ckrautwald/OpenTendo/adapters/ra2/previews/adapter-3d.png

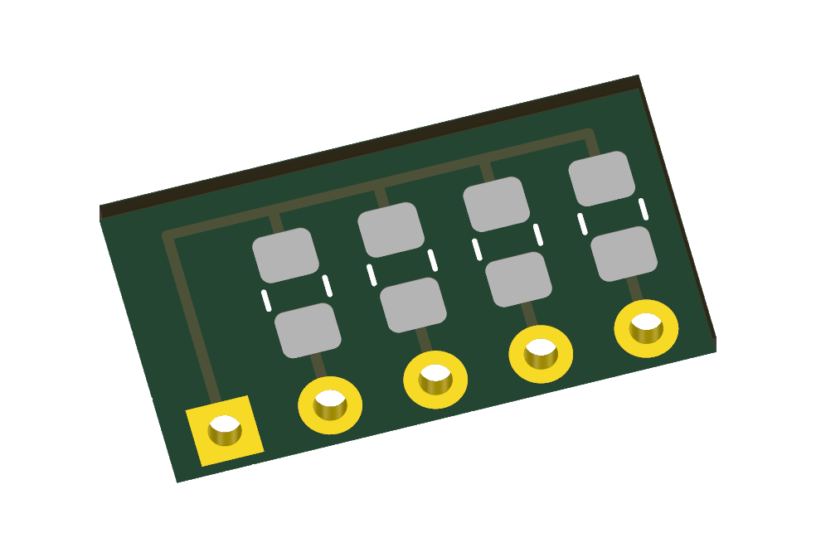
adapters/ra2/previews/adapter-3d.png
