ckrautwald/OpenTendo/BOM/BOM.csv

Query | Qty | Manufacturer | MPN | Octopart URL | Part Description | Description | Schematic Reference | Internal Part Number | Lifecycle | Lead Time | RoHS | Total Qty (@ Batch Size: 1) | SKU | SKU | SKU | SKU | SKU | Packaging | Packaging | Packaging | Packaging | Packaging | Unit Price (@ Batch Size: 1) | Unit Price (@ Batch Size: 1) | Unit Price (@ Batch Size: 1) | Unit Price (@ Batch Size: 1) | Unit Price (@ Batch Size: 1) | In Stock | In Stock | In Stock | In Stock | In Stock | MOQ | MOQ | MOQ | MOQ | MOQ | URL | URL | URL | URL | URL | Distributor [Lowest Price (Preferred Distributors)] | SKU [Lowest Price (Preferred Distributors)] | Packaging [Lowest Price (Preferred Distributors)] | Unit Price (@ Batch Size: 1) [Lowest Price (Preferred Distributors)] | Line Total [Lowest Price (Preferred Distributors)] | Batch Total [Lowest Price (Preferred Distributors)] | In Stock [Lowest Price (Preferred Distributors)] | MOQ [Lowest Price (Preferred Distributors)] | URL [Lowest Price (Preferred Distributors)] | Notes
 |  |  |  |  |  |  |  |  |  |  |  |  | Digi-Key | Mouser | Newark | Onlinecomponents.com | RS Components | Digi-Key | Mouser | Newark | Onlinecomponents.com | RS Components | Digi-Key | Mouser | Newark | Onlinecomponents.com | RS Components | Digi-Key | Mouser | Newark | Onlinecomponents.com | RS Components | Digi-Key | Mouser | Newark | Onlinecomponents.com | RS Components | Digi-Key | Mouser | Newark | Onlinecomponents.com | RS Components
CSTLS4M00G56-B0 | 1 | Murata | CSTLS4M00G56-B0 | https://octopart.com/cstls4m00g56-b0-murata-10326657 | Ceramic Resonator 4MHz ±0.5% (Tol) -0.4/0.2% (Stability) 47pF 30Ohm 3-Pin Thru-Hole Bulk |  | X2 |  | NRND (Last Updated: 2 weeks ago) | 15w | Compliant | 1 | 490-7036-ND | 81-CSTLS4M00G56-B0 | 70AC3726 |  |  | Bulk | Bulk |  |  |  | 0.21 | 0.21 | 0.209 |  |  | 4715 | 2001 | 324 |  |  | 1 | 1 | 1 |  |  | https://octopart.com/opatz8j6/a1 | https://octopart.com/opatz8j6/a1 | https://octopart.com/opatz8j6/a1 |  |  | Newark | 70AC3726 |  | 0.209 | 0.209 | 0.209 | 324 | 1 | https://octopart.com/opatz8j6/a1
ECS-214-S-4X | 1 | ECS International | ECS-214-S-4X | https://octopart.com/ecs-214-s-4x-ecs+international-88334749 |  |  | X1 |  |  |  | Compliant | 1 |  | 520-HCU2147-SX |  |  |  |  | Bulk |  |  |  |  | 0.69 |  |  |  |  | 558 |  |  |  |  | 1 |  |  |  |  | https://octopart.com/opatz8j6/a1 |  |  |  | Mouser | 520-HCU2147-SX | Bulk | 0.69 | 0.69 | 0.69 | 558 | 1 | https://octopart.com/opatz8j6/a1
SN74HCU04N | 1 | Texas Instruments | SN74HCU04N | https://octopart.com/sn74hcu04n-texas+instruments-465549 | Gate / Inverter Logic IC Leaded Process; function (IC): Hex Inverter; Base Number: 7404 |  | U9 |  | Production (Last Updated: 1 week ago) | 1w | Compliant | 1 | 296-9820-5-ND | 595-SN74HCU04N |  |  |  | Tube | Tube |  |  |  | 0.63 | 0.59 |  |  |  | 2448 | 1088 |  |  |  | 1 | 1 |  |  |  | https://octopart.com/opatz8j6/a1 | https://octopart.com/opatz8j6/a1 |  |  |  | Mouser | 595-SN74HCU04N | Tube | 0.59 | 0.59 | 0.59 | 1088 | 1 | https://octopart.com/opatz8j6/a1
SN74HC368N | 1 | Texas Instruments | SN74HC368N | https://octopart.com/sn74hc368n-texas+instruments-51845 | Buffer/Line Driver 6-CH Inverting 3-ST CMOS 16-Pin PDIP Tube |  | U8 |  | Production (Last Updated: 1 week ago) | 1w | Compliant | 1 | 296-8308-5-ND | 595-SN74HC368N |  |  |  | Tube | Tube |  |  |  | 0.65 | 0.57 |  |  |  | 4259 | 951 |  |  |  | 1 | 1 |  |  |  | https://octopart.com/opatz8j6/a1 | https://octopart.com/opatz8j6/a1 |  |  |  | Mouser | 595-SN74HC368N | Tube | 0.57 | 0.57 | 0.57 | 951 | 1 | https://octopart.com/opatz8j6/a1
SN74HC368N | 1 | Texas Instruments | SN74HC368N | https://octopart.com/sn74hc368n-texas+instruments-51845 | Buffer/Line Driver 6-CH Inverting 3-ST CMOS 16-Pin PDIP Tube |  | U7 |  | Production (Last Updated: 1 week ago) | 1w | Compliant | 1 | 296-8308-5-ND | 595-SN74HC368N |  |  |  | Tube | Tube |  |  |  | 0.65 | 0.57 |  |  |  | 4259 | 951 |  |  |  | 1 | 1 |  |  |  | https://octopart.com/opatz8j6/a1 | https://octopart.com/opatz8j6/a1 |  |  |  | Mouser | 595-SN74HC368N | Tube | 0.57 | 0.57 | 0.57 | 951 | 1 | https://octopart.com/opatz8j6/a1
ED40DT | 2 | On Shore Technology | ED40DT | https://octopart.com/ed40dt-on+shore+technology-5349672 | Conn DIP Socket SKT 40 POS Solder ST Thru-Hole |  | U5, U6 |  |  | 8w | Compliant | 2 | ED3048-5-ND |  |  |  |  | Tube |  |  |  |  | 0.59 |  |  |  |  | 1677 |  |  |  |  | 1 |  |  |  |  | https://octopart.com/opatz8j6/a1 |  |  |  |  | DigiKey | ED3048-5-ND | Tube | 0.59 | 1.18 | 1.18 | 1677 | 1 | https://octopart.com/opatz8j6/a1
SN74HC139N | 1 | Texas Instruments | SN74HC139N | https://octopart.com/sn74hc139n-texas+instruments-17212 | Decoder/Demultiplexer; Dual 2 to 4 Line Decoder-Demultiplexer; 0 to 5 V; PDIP |  | U3 |  | Production (Last Updated: 1 week ago) | 1w | Compliant | 1 | 296-8230-5-ND | 595-SN74HC139N | 33AH4851 |  |  | Tube | Tube |  |  |  | 1.31 | 1.28 | 0.147 |  |  | 102 | 1545 | 19 |  |  | 1 | 1 | 1 |  |  | https://octopart.com/opatz8j6/a1 | https://octopart.com/opatz8j6/a1 | https://octopart.com/opatz8j6/a1 |  |  | Newark | 33AH4851 |  | 0.147 | 0.147 | 0.147 | 19 | 1 | https://octopart.com/opatz8j6/a1
SN74HC373N | 1 | Texas Instruments | SN74HC373N | https://octopart.com/sn74hc373n-texas+instruments-471147 | Latch; Octal Transparent D-Type Latch; 0 to 5 V; 500 ns (Max.) @ 4.5 V; PDIP-N |  | U2 |  | Production (Last Updated: 1 week ago) | 6w | Compliant | 1 | 296-1591-5-ND | 595-SN74HC373N | 29AH1488 |  |  | Tube | Tube |  |  |  | 0.82 | 0.78 | 0.822 |  |  | 0 | 130 | 50 |  |  | 1 | 1 | 1 |  |  | https://octopart.com/opatz8j6/a1 | https://octopart.com/opatz8j6/a1 | https://octopart.com/opatz8j6/a1 |  |  | Mouser | 595-SN74HC373N | Tube | 0.78 | 0.78 | 0.78 | 130 | 1 | https://octopart.com/opatz8j6/a1
6116SA15SOG | 2 | Renesas | 6116SA15SOG | https://octopart.com/6116sa15sog-renesas-106910578 | SRAM Chip Async Single 5V 16K-Bit 2K x 8 15ns 24-Pin SOIC Tube/Tray |  | U1, U4 |  | Production (Last Updated: 1 week ago) | 1w | Compliant | 2 | 6116SA15SOG-ND | 972-6116SA15SOG |  |  |  | Tube | Tube |  |  |  | 6.44 | 6.19 |  |  |  | 282 | 202 |  |  |  | 1 | 1 |  |  |  | https://octopart.com/opatz8j6/a1 | https://octopart.com/opatz8j6/a1 |  |  |  | Mouser | 972-6116SA15SOG | Tube | 6.19 | 12.38 | 12.38 | 202 | 1 | https://octopart.com/opatz8j6/a1 | Alternate: Renesas 6116SA15TPG
PA0009 | 2 | Chip Quik | PA0009 | https://octopart.com/pa0009-chip+quik-51024752 | SOIC-24 to DIP-24 SMT Adapter |  | U1, U4 |  |  | 4w | Compliant | 2 | PA0009-ND | 910-PA0009 |  |  |  | Bulk |  |  |  |  | 5.29 | 5.29 |  |  |  | 222 | 100 |  |  |  | 1 | 1 |  |  |  | https://octopart.com/opatz8j6/a1 | https://octopart.com/opatz8j6/a1 |  |  |  | DigiKey | PA0009-ND | Bulk | 5.29 | 10.58 | 10.58 | 222 | 1 | https://octopart.com/opatz8j6/a1
4613X-101-103LF | 1 | Bourns | 4613X-101-103LF | https://octopart.com/4613x-101-103lf-bourns-1656444 | Res Thick Film NET 10K Ohm 2% 1.63W ±100ppm/°C BUS Conformal 13-Pin SIP Pin Thru-Hole Bulk |  | RA1 |  |  | 15w | Compliant | 1 | 4613X-101-103LF-ND | 652-4613X-1LF-10K | 67AC8758 | 4613X-101-103LF |  | Bulk | Bulk |  | Bulk |  | 0.75 | 0.59 | 0.643 |  |  | 887 | 704 | 541 | 0 |  | 1 | 1 | 1 | 500 |  | https://octopart.com/opatz8j6/a1 | https://octopart.com/opatz8j6/a1 | https://octopart.com/opatz8j6/a1 | https://octopart.com/opatz8j6/a1 |  | Mouser | 652-4613X-1LF-10K | Bulk | 0.59 | 0.59 | 0.59 | 704 | 1 | https://octopart.com/opatz8j6/a1
RC0805FR-076K8L | 4 | Yageo | RC0805FR-076K8L |  | 6.8 kohm 1% 0805 thick-film resistor | Four discrete pull-ups replace RA2 common-bus array | R20, R21, R22, R23 |  |  |  |  | 4
CF18JT1K00 | 2 | Stackpole Electronics | CF18JT1K00 | https://octopart.com/cf18jt1k00-stackpole+electronics-19205674 | Res Carbon Film 1K Ohm 5% 0.125W(1/8W) -400ppm/ to 0ppm/ Conformal Coated AXL T/R |  | R18, R19 |  |  | 17w | Compliant | 2 | CF18JT1K00CT-ND | 708-CF18JT1K00 |  | CF18JT1K00 |  | Cut Tape | Tape & Reel |  | Bulk |  | 0.1 | 0.1 |  |  |  | 138926 | 31947 |  | 15000 |  | 1 | 1 |  | 5000 |  | https://octopart.com/opatz8j6/a1 | https://octopart.com/opatz8j6/a1 |  | https://octopart.com/opatz8j6/a1 |  | DigiKey | CF18JT1K00CT-ND | Cut Tape | 0.1 | 0.2 | 0.2 | 138926 | 1 | https://octopart.com/opatz8j6/a1
CF14JT2K20 | 1 | Stackpole Electronics | CF14JT2K20 | https://octopart.com/cf14jt2k20-stackpole+electronics-19205454 | CF FIXED RESISTOR Axial Through Hole Resistor ±5% 0/ -400ppm/C 2.2kOhm 0.25W 1/4W |  | R17 |  |  | 17w | Compliant | 1 | CF14JT2K20CT-ND | 708-CF14JT2K20 | 31AC8468 | CF14JT2K20 |  | Cut Tape | Tape & Reel | Tape & Reel | Bulk |  | 0.1 | 0.1 |  |  |  | 157243 | 82839 | 10000 | 75000 |  | 1 | 1 | 5000 | 5000 |  | https://octopart.com/opatz8j6/a1 | https://octopart.com/opatz8j6/a1 | https://octopart.com/opatz8j6/a1 | https://octopart.com/opatz8j6/a1 |  | DigiKey | CF14JT2K20CT-ND | Cut Tape | 0.1 | 0.1 | 0.1 | 157243 | 1 | https://octopart.com/opatz8j6/a1
CFR-25JB-52-150K | 1 | Yageo | CFR-25JB-52-150K | https://octopart.com/cfr-25jb-52-150k-yageo-22569037 | General Type Carbon Film Resistor 150kOhm 1/4W 5% Axial Bulk |  | R13 |  |  | 16w | Compliant | 1 | 150KQBK-ND | 603-CFR-25JB-52-150K | 49AK4906 |  |  | Bulk | Bulk |  |  |  | 0.1 | 0.1 | 0.01 |  |  | 6389 | 1788 | 8393 |  |  | 1 | 1 | 1 |  |  | https://octopart.com/opatz8j6/a1 | https://octopart.com/opatz8j6/a1 | https://octopart.com/opatz8j6/a1 |  |  | Newark | 49AK4906 |  | 0.01 | 0.01 | 0.01 | 8393 | 1 | https://octopart.com/opatz8j6/a1
CF18JT1K20 | 1 | Stackpole Electronics | CF18JT1K20 | https://octopart.com/cf18jt1k20-stackpole+electronics-19205676 | CF FIXED RESISTOR Axial Through Hole Resistor ±5% 0/ -400ppm/C 1.2kOhm 0.125W 1/8W |  | R11 |  |  | 17w | Compliant | 1 | CF18JT1K20CT-ND | 708-CF18JT1K20 |  | CF18JT1K20 |  | Cut Tape | Tape & Reel |  | Bulk |  | 0.1 | 0.1 |  |  |  | 16462 | 9887 |  | 0 |  | 1 | 1 |  | 5000 |  | https://octopart.com/opatz8j6/a1 | https://octopart.com/opatz8j6/a1 |  | https://octopart.com/opatz8j6/a1 |  | DigiKey | CF18JT1K20CT-ND | Cut Tape | 0.1 | 0.1 | 0.1 | 16462 | 1 | https://octopart.com/opatz8j6/a1
CF18JT220K | 1 | Stackpole Electronics | CF18JT220K | https://octopart.com/cf18jt220k-stackpole+electronics-19205700 | CF FIXED RESISTOR Axial Through Hole Resistor ±5% 0/ -850ppm/C 220kOhm 0.125W 1/8W |  | R10 |  |  | 17w | Compliant | 1 | CF18JT220KCT-ND | 708-CF18JT220K |  | CF18JT220K |  | Cut Tape | Tape & Reel |  | Bulk |  | 0.1 | 0.1 |  |  |  | 30939 | 9700 |  | 0 |  | 1 | 1 |  | 5000 |  | https://octopart.com/opatz8j6/a1 | https://octopart.com/opatz8j6/a1 |  | https://octopart.com/opatz8j6/a1 |  | DigiKey | CF18JT220KCT-ND | Cut Tape | 0.1 | 0.1 | 0.1 | 30939 | 1 | https://octopart.com/opatz8j6/a1
CF18JT12K0 | 1 | Stackpole Electronics | CF18JT12K0 | https://octopart.com/cf18jt12k0-stackpole+electronics-19205652 | CF FIXED RESISTOR Axial Through Hole Resistor ±5% 0/ -500ppm/C 12kOhm 0.125W 1/8W |  | R8 |  |  | 17w | Compliant | 1 | CF18JT12K0CT-ND | 708-CF18JT12K0 |  | CF18JT12K0 |  | Cut Tape | Tape & Reel |  | Bulk |  | 0.1 | 0.1 |  |  |  | 16632 | 9736 |  | 0 |  | 1 | 1 |  | 5000 |  | https://octopart.com/opatz8j6/a1 | https://octopart.com/opatz8j6/a1 |  | https://octopart.com/opatz8j6/a1 |  | DigiKey | CF18JT12K0CT-ND | Cut Tape | 0.1 | 0.1 | 0.1 | 16632 | 1 | https://octopart.com/opatz8j6/a1
CF18JT20K0 | 2 | Stackpole Electronics | CF18JT20K0 | https://octopart.com/cf18jt20k0-stackpole+electronics-19205697 | CF FIXED RESISTOR Axial Through Hole Resistor ±5% 0/ -500ppm/C 20kOhm 0.125W 1/8W |  | R7, R9 |  |  | 17w | Compliant | 2 | CF18JT20K0CT-ND | 708-CF18JT20K0 |  | CF18JT20K0 |  | Cut Tape | Tape & Reel |  | Bulk |  | 0.1 | 0.1 |  |  |  | 66822 | 22435 |  | 0 |  | 1 | 1 |  | 5000 |  | https://octopart.com/opatz8j6/a1 | https://octopart.com/opatz8j6/a1 |  | https://octopart.com/opatz8j6/a1 |  | DigiKey | CF18JT20K0CT-ND | Cut Tape | 0.1 | 0.2 | 0.2 | 66822 | 1 | https://octopart.com/opatz8j6/a1
CF18JT47K0 | 1 | Stackpole Electronics | CF18JT47K0 | https://octopart.com/cf18jt47k0-stackpole+electronics-19205759 | Res Carbon Film 47K Ohm 5% 0.125W(1/8W) -500ppm/ to 0ppm/ Conformal Coated AXL T/R |  | R6 |  |  | 17w | Compliant | 1 | CF18JT47K0CT-ND | 708-CF18JT47K0 |  | CF18JT47K0 |  | Cut Tape | Tape & Reel |  | Bulk |  | 0.1 | 0.1 |  |  |  | 205528 | 10457 |  | 35000 |  | 1 | 1 |  | 5000 |  | https://octopart.com/opatz8j6/a1 | https://octopart.com/opatz8j6/a1 |  | https://octopart.com/opatz8j6/a1 |  | DigiKey | CF18JT47K0CT-ND | Cut Tape | 0.1 | 0.1 | 0.1 | 205528 | 1 | https://octopart.com/opatz8j6/a1
CF18JT220R | 1 | Stackpole Electronics | CF18JT220R | https://octopart.com/cf18jt220r-stackpole+electronics-19205701 | CF FIXED RESISTOR Axial Through Hole Resistor ±5% 0/ -400ppm/C 220Ohm 0.125W 1/8W |  | R5 |  |  | 17w | Compliant | 1 | CF18JT220RCT-ND | 708-CF18JT220R |  | CF18JT220R |  | Cut Tape | Tape & Reel |  | Bulk |  | 0.1 | 0.1 |  |  |  | 44352 | 7668 |  | 0 |  | 1 | 1 |  | 5000 |  | https://octopart.com/opatz8j6/a1 | https://octopart.com/opatz8j6/a1 |  | https://octopart.com/opatz8j6/a1 |  | DigiKey | CF18JT220RCT-ND | Cut Tape | 0.1 | 0.1 | 0.1 | 44352 | 1 | https://octopart.com/opatz8j6/a1
CF18JT100R | 2 | Stackpole Electronics | CF18JT100R | https://octopart.com/cf18jt100r-stackpole+electronics-19205641 | Res Carbon Film 100 Ohm 5% 0.125W(1/8W) -400ppm/ to 0ppm/ Conformal Coated AXL T/R |  | R3, R4 |  |  | 17w | Compliant | 2 | CF18JT100RCT-ND | 708-CF18JT100R |  | CF18JT100R |  | Cut Tape | Tape & Reel |  | Bulk |  | 0.1 | 0.1 |  |  |  | 80062 | 446 |  | 0 |  | 1 | 1 |  | 5000 |  | https://octopart.com/opatz8j6/a1 | https://octopart.com/opatz8j6/a1 |  | https://octopart.com/opatz8j6/a1 |  | DigiKey | CF18JT100RCT-ND | Cut Tape | 0.1 | 0.2 | 0.2 | 80062 | 1 | https://octopart.com/opatz8j6/a1
CF18JT510R | 2 | Stackpole Electronics | CF18JT510R | https://octopart.com/cf18jt510r-stackpole+electronics-19205768 | CF FIXED RESISTOR Axial Through Hole Resistor ±5% 0/ -400ppm/C 510Ohm 0.125W 1/8W |  | R2, R12 |  |  | 17w | Compliant | 2 | CF18JT510RCT-ND | 708-CF18JT510R |  | CF18JT510R |  | Cut Tape | Tape & Reel |  | Bulk |  | 0.1 | 0.1 |  |  |  | 37165 | 9636 |  | 0 |  | 1 | 1 |  | 5000 |  | https://octopart.com/opatz8j6/a1 | https://octopart.com/opatz8j6/a1 |  | https://octopart.com/opatz8j6/a1 |  | DigiKey | CF18JT510RCT-ND | Cut Tape | 0.1 | 0.2 | 0.2 | 37165 | 1 | https://octopart.com/opatz8j6/a1
RNF14FTD1M00 | 1 | Stackpole Electronics | RNF14FTD1M00 | https://octopart.com/rnf14ftd1m00-stackpole+electronics-19224733 | RNF FIXED RESISTOR Axial Through Hole Resistor ±1% ±100ppm/C 1MOhm 0.25W 1/4W |  | R1 |  |  | 17w | Compliant | 1 | RNF14FTD1M00CT-ND | 708-RNF14FTD1M00 |  | RNF14FTD1M00 |  | Cut Tape | Tape & Reel |  | Bulk |  | 0.1 | 0.1 |  |  |  | 45933 | 43168 |  | 10000 |  | 1 | 1 |  | 5000 |  | https://octopart.com/opatz8j6/a1 | https://octopart.com/opatz8j6/a1 |  | https://octopart.com/opatz8j6/a1 |  | DigiKey | RNF14FTD1M00CT-ND | Cut Tape | 0.1 | 0.1 | 0.1 | 45933 | 1 | https://octopart.com/opatz8j6/a1
2SC2021 | 2 | ROHM | 2SC2021 | https://octopart.com/2sc2021-rohm-2177186 |  |  | Q2, Q3 |  |  |  | Non-Compliant | 2
2SA937 | 1 | ROHM | 2SA937 | https://octopart.com/2sa937-rohm-2179925 |  |  | Q1 |  |  |  | Non-Compliant | 1
S7B-PH-K-S(LF)(SN) | 2 | JST | S7B-PH-K-S (LF)(SN) | https://octopart.com/s7b-ph-k-s+%28lf%29%28sn%29-jst-5373080 | Header for PCB; pitch 2.00mm; 7-contacts; THT; male; side entry; 100V/2A |  | P4, P5 |  |  |  | Compliant | 2 |  |  | 38K8083 |  |  |  |  |  |  |  |  |  |  |  |  |  |  | 78 |  |  |  |  | 10 |  |  |  |  | https://octopart.com/opatz8j6/a1 |  |  | Newark | 38K8083 |  |  |  |  | 78 | 10 | https://octopart.com/opatz8j6/a1
PPPC241LFBN-RC | 2 | Sullins | PPPC241LFBN-RC | https://octopart.com/pppc241lfbn-rc-sullins-271073 | 24 Position Header Connector 0.100 (2.54mm) Through Hole Gold |  | P2 |  |  | 11w | Compliant | 2 | S7057-ND |  |  |  |  | Tray |  |  |  |  | 1.77 |  |  |  |  | 2637 |  |  |  |  | 1 |  |  |  |  | https://octopart.com/opatz8j6/a1 |  |  |  |  | DigiKey | S7057-ND | Tray | 1.77 | 3.54 | 3.54 | 2637 | 1 | https://octopart.com/opatz8j6/a1
28L0138-10R-10 | 1 | Laird | 28L0138-10R-10 | https://octopart.com/28l0138-10r-10-laird-19252911 | Emi Ferrite Bead With Axial Wire, 5A, 75 Ohms @100MHZ, Dcr Max 0.01 Ohm |  | FC2 |  | Production (Last Updated: 3 years ago) | 14w | Compliant | 1 | 240-2438-1-ND | 875-28L0138-10R-10 | 67W0706 |  |  | Cut Tape | Tape & Reel | Cut Tape |  |  | 0.24 | 0.24 |  |  |  | 41197 | 27634 | 17994 |  |  | 1 | 1 | 10 |  |  | https://octopart.com/opatz8j6/a1 | https://octopart.com/opatz8j6/a1 | https://octopart.com/opatz8j6/a1 |  |  | DigiKey | 240-2438-1-ND | Cut Tape | 0.24 | 0.24 | 0.24 | 41197 | 1 | https://octopart.com/opatz8j6/a1
B78108S1393K | 1 | EPCOS | B78108S1393K | https://octopart.com/b78108s1393k-epcos-39569030 | Fixed Inductor RF Choke 39uH 10% Wirewound 470mA 1020 mOhm Unshielded Axial |  | FC1 |  | Production (Last Updated: 2 years ago) | 9w | Compliant | 1 | 495-5565-1-ND | 871-B78108S1393K |  |  |  | Cut Tape | Tape & Reel |  |  |  | 0.3 | 0.32 |  |  |  | 9658 | 6091 |  |  |  | 1 | 1 |  |  |  | https://octopart.com/opatz8j6/a1 | https://octopart.com/opatz8j6/a1 |  |  |  | DigiKey | 495-5565-1-ND | Cut Tape | 0.3 | 0.3 | 0.3 | 9658 | 1 | https://octopart.com/opatz8j6/a1
DAN601 | 2 | ROHM | DAN601 | https://octopart.com/dan601-rohm-14372173 |  | small signal diode array | DA1, DA3 |  |  |  | Non-Compliant | 2
1N5231BTR | 2 | onsemi | 1N5231BTR | https://octopart.com/1n5231btr-onsemi-12156453 | 1N5231 Series 500 mW 5.1 V 200 mA Through Hole Zener Diode - DO-35 |  | D1, D2 |  | Production (Last Updated: 3 years ago) | 22w | Compliant | 2 | 1N5231BFSCT-ND | 512-1N5231BTR | 05R0368 | 1N5231BTR |  | Cut Tape | Tape & Reel | Cut Tape | Bulk |  | 0.1 | 0.14 | 0.158 |  |  | 38386 | 63101 | 20617 | 120000 |  | 1 | 1 | 1 | 5000 |  | https://octopart.com/opatz8j6/a1 | https://octopart.com/opatz8j6/a1 | https://octopart.com/opatz8j6/a1 | https://octopart.com/opatz8j6/a1 |  | DigiKey | 1N5231BFSCT-ND | Cut Tape | 0.1 | 0.2 | 0.2 | 38386 | 1 | https://octopart.com/opatz8j6/a1
K560J15C0GF5TL2 | 2 | Vishay | K560J15C0GF5TL2 | https://octopart.com/k560j15c0gf5tl2-vishay-39474510 | Capacitor Ceramic 56PF 50V, C0G/NP0, 5%, |  | C43, C45 |  |  | 17w | Compliant | 2 | BC1010CT-ND | 594-K560J15C0GF5TL2 | 73AJ7908 |  |  | Cut Tape | Tape & Reel |  |  |  | 0.24 | 0.24 |  |  |  | 28892 | 14404 | 17730 |  |  | 1 | 1 | 10 |  |  | https://octopart.com/opatz8j6/a1 | https://octopart.com/opatz8j6/a1 | https://octopart.com/opatz8j6/a1 |  |  | Mouser | 594-K560J15C0GF5TL2 | Tape & Reel | 0.24 | 0.48 | 0.48 | 14404 | 1 | https://octopart.com/opatz8j6/a1
K150J15C0GF5TL2 | 1 | Vishay | K150J15C0GF5TL2 | https://octopart.com/k150j15c0gf5tl2-vishay-39474466 | K Series 15 pF 50 V ±5 % Tolerance C0G Radial Multilayer Ceramic Capacitor |  | C42 |  |  | 17w | Compliant | 1 | BC1003CT-ND | 594-K150J15C0GF5TL2 | 95C0990 |  |  | Cut Tape | Tape & Reel | Cut Tape |  |  | 0.25 | 0.25 | 0.048 |  |  | 37400 | 23292 | 5373 |  |  | 1 | 1 | 1 |  |  | https://octopart.com/opatz8j6/a1 | https://octopart.com/opatz8j6/a1 | https://octopart.com/opatz8j6/a1 |  |  | Newark | 95C0990 | Cut Tape | 0.048 | 0.048 | 0.048 | 5373 | 1 | https://octopart.com/opatz8j6/a1
C315C180J5G5TA | 1 | KEMET | C315C180J5G5TA | https://octopart.com/c315c180j5g5ta-kemet-1839992 | Cap Ceramic 18pF 50V C0G 5% Radial 2.54mm 125 C Bulk |  | C41 |  |  | 13w | Compliant | 1 | 399-C315C180J5G5TA-ND | 80-C315C180J5G5TA |  |  |  | Bulk | Bulk |  |  |  | 0.43 | 0.28 |  |  |  | 480 | 2574 |  |  |  | 1 | 1 |  |  |  | https://octopart.com/opatz8j6/a1 | https://octopart.com/opatz8j6/a1 |  |  |  | Mouser | 80-C315C180J5G5TA | Bulk | 0.28 | 0.28 | 0.28 | 2574 | 1 | https://octopart.com/opatz8j6/a1 | Alternate: TDK FG18C0G1H180JNT00
UVR2A010MDD1TD | 1 | Nichicon | UVR2A010MDD1TD | https://octopart.com/uvr2a010mdd1td-nichicon-10319218 | Radial Can ALUMINUM ELECTROLYTIC CAPACITOR UVR 100V 1muF ±20% 0.197Dia 5.00mm |  | C23 |  |  | 21w | Compliant | 1 | 493-12811-1-ND | 647-UVR2A010MDD1TD |  |  |  | Cut Tape | Ammo Pack |  |  |  | 0.27 | 0.26 |  |  |  | 2203 | 3474 |  |  |  | 1 | 1 |  |  |  | https://octopart.com/opatz8j6/a1 | https://octopart.com/opatz8j6/a1 |  |  |  | Mouser | 647-UVR2A010MDD1TD | Ammo Pack | 0.26 | 0.26 | 0.26 | 3474 | 1 | https://octopart.com/opatz8j6/a1
K221K15X7RF5TL2 | 3 | Vishay | K221K15X7RF5TL2 | https://octopart.com/k221k15x7rf5tl2-vishay-39474895 | Cap Ceramic 220pF 50V X7R 10% Radial 2.5mm 125C T/R |  | C20, C21, C44 |  |  | 17w | Compliant | 3 | BC1068CT-ND | 594-K221K15X7RF5TL2 | 57AC2378 |  |  | Cut Tape | Tape & Reel |  |  |  | 0.24 | 0.24 |  |  |  | 28648 | 29955 | 31050 |  |  | 1 | 1 | 10 |  |  | https://octopart.com/opatz8j6/a1 | https://octopart.com/opatz8j6/a1 | https://octopart.com/opatz8j6/a1 |  |  | Mouser | 594-K221K15X7RF5TL2 | Tape & Reel | 0.24 | 0.72 | 0.72 | 29955 | 1 | https://octopart.com/opatz8j6/a1
ECA-1HHG2R2I | 1 | Panasonic | ECA-1HHG2R2I | https://octopart.com/eca-1hhg2r2i-panasonic-12553061 | Cap Aluminum Lytic 2.2uF 50V 20% (5 X 11mm) Radial 2.5mm 18mA 1000h 105C Automotive Ammo |  | C9 |  | Production (Last Updated: 3 years ago) | 21w | Compliant | 1 | P19525CT-ND | 667-ECA-1HHG2R2I | 74AK7354 | ECA-1HHG2R2I |  | Cut Tape | Tape & Reel |  | Bulk |  | 0.27 | 0.26 |  |  |  | 12954 | 4884 | 5910 | 2000 |  | 1 | 1 | 5 | 2000 |  | https://octopart.com/opatz8j6/a1 | https://octopart.com/opatz8j6/a1 | https://octopart.com/opatz8j6/a1 | https://octopart.com/opatz8j6/a1 |  | Mouser | 667-ECA-1HHG2R2I | Tape & Reel | 0.26 | 0.26 | 0.26 | 4884 | 1 | https://octopart.com/opatz8j6/a1
K104K15X7RF5UH5 | 2 | Vishay | K104K15X7RF5UH5 | https://octopart.com/k104k15x7rf5uh5-vishay-40993312 | Cap Ceramic 0.1uF 50V X7R 10% Through Hole 5mm 125°C Ammo Pack |  | C8, C46 |  |  | 17w | Compliant | 2 | BC5229CT-ND | 594-K104K15X7RF5UH5 |  |  |  | Cut Tape | Ammo Pack |  |  |  | 0.26 | 0.26 |  |  |  | 35561 | 70148 |  |  |  | 1 | 1 |  |  |  | https://octopart.com/opatz8j6/a1 | https://octopart.com/opatz8j6/a1 |  |  |  | DigiKey | BC5229CT-ND | Cut Tape | 0.26 | 0.52 | 0.52 | 35561 | 1 | https://octopart.com/opatz8j6/a1
K331K15X7RF53L2 | 11 | Vishay | K331K15X7RF53L2 | https://octopart.com/k331k15x7rf53l2-vishay-42623274 | Ceramic Capacitor, Multilayer, Ceramic, 50V, 10% +Tol, 10% -Tol, X7R, 15% TC, 0.00033uF, Through Hole Mount |  | C5, C27, C28, C29, C30, C31, C33, C34, C35, C36, C37 |  |  | 17w | Compliant | 11 | BC5150-ND | 594-K331K15X7RF53L2 |  |  |  | Bulk | Bulk |  |  |  | 0.143 | 0.102 |  |  |  | 22142 | 34228 |  |  |  | 1 | 1 |  |  |  | https://octopart.com/opatz8j6/a1 | https://octopart.com/opatz8j6/a1 |  |  |  | Mouser | 594-K331K15X7RF53L2 | Bulk | 0.102 | 1.1219999999999999 | 1.1219999999999999 | 34228 | 1 | https://octopart.com/opatz8j6/a1
K103K10X7RF5UH5 | 20 | Vishay | K103K10X7RF5UH5 | https://octopart.com/k103k10x7rf5uh5-vishay-44280222 | Multilayer Ceramic Capacitor, 0.01 uF, 50 V, ï¿½ 10%, X7R, Radial Leaded |  | C2, C3, C4, C10, C11, C12, C13, C14, C15, C16, C17, C18, C19, C22, C24, C26, C32, C38, C39, C40 |  |  | 17w | Compliant | 20 | BC2662CT-ND | 594-K103K10X7RF5UH5 | 92K1095 |  |  | Cut Tape | Ammo Pack |  |  |  | 0.16 | 0.101 | 0.04 |  |  | 43219 | 32443 | 8363 |  |  | 1 | 1 | 1 |  |  | https://octopart.com/opatz8j6/a1 | https://octopart.com/opatz8j6/a1 | https://octopart.com/opatz8j6/a1 |  |  | Newark | 92K1095 |  | 0.04 | 0.8 | 0.8 | 8363 | 1 | https://octopart.com/opatz8j6/a1
ECE-A0JKA101I | 1 | Panasonic | ECE-A0JKA101I | https://octopart.com/ece-a0jka101i-panasonic-15327038 | Cap Aluminum 100uF 6.3V 20% (5 X 7mm) Radial 2.5mm 71mA 1000 hr 85°C Ammo Pack |  | C1 |  |  | 21w | Compliant | 1 | 10-ECE-A0JKA101ICT-ND | 667-ECE-A0JKA101I |  | ECE-A0JKA101I |  | Cut Tape | Tape & Reel |  | Bulk |  | 0.25 | 0.24 |  |  |  | 761 | 3609 |  | 6776 |  | 1 | 1 |  | 2000 |  | https://octopart.com/opatz8j6/a1 | https://octopart.com/opatz8j6/a1 |  | https://octopart.com/opatz8j6/a1 |  | Mouser | 667-ECE-A0JKA101I | Tape & Reel | 0.24 | 0.24 | 0.24 | 3609 | 1 | https://octopart.com/opatz8j6/a1
K153K10X7RF5UH5 | 2 | Vishay | K153K10X7RF5UH5 | https://octopart.com/k153k10x7rf5uh5-vishay-44033224 | Multilayer Ceramic Capacitors MLCC - Leaded 15000pF 50V 10% X7R 5mm LS |  | BC1, BC2 |  |  | 17w | Compliant | 2 | BC2671CT-ND | 594-K153K10X7RF5UH5 |  |  |  | Cut Tape | Ammo Pack |  |  |  | 0.24 | 0.24 |  |  |  | 18058 | 15044 |  |  |  | 1 | 1 |  |  |  | https://octopart.com/opatz8j6/a1 | https://octopart.com/opatz8j6/a1 |  |  |  | DigiKey | BC2671CT-ND | Cut Tape | 0.24 | 0.48 | 0.48 | 18058 | 1 | https://octopart.com/opatz8j6/a1
GKG30015 | 1 | Panasonic | GKG30015 | https://octopart.com/gkg30015-panasonic-120079986 | Cap Trimmer 6.5-30PF 100V Th |  | TC1 |  |  | 22w |  | 1 | 2447-GKG30015-ND |  |  |  |  | Bulk |  |  |  |  | 1.32 |  |  |  |  | 15739 |  |  |  |  | 1 |  |  |  |  | https://octopart.com/opatz8j6/a1 |  |  |  |  | DigiKey | 2447-GKG30015-ND | Bulk | 1.32 | 1.32 | 1.32 | 15739 | 1 | https://octopart.com/opatz8j6/a1
