ckrautwald/OpenTendo/adapters/ra2/BOM.csv

Reference | Quantity | Manufacturer | Part number | Description
R1 R2 R3 R4 | 4 | Yageo | RC0805FR-076K8L | 6.8 kohm 1% 0805 resistor
J1 | 5 | Unselected | Unselected | 0.5 mm diameter round tinned copper wire leads cut to length; qualify mechanically
PCB | 1 | Unselected | RA2-modern-adapter | 13 x 7 mm 2-layer 0.8 mm prototype board
