ckrautwald/OpenTendo/Board Files/Motherboard.kicad_pcb

## KiCad design Board Files/Motherboard.kicad_pcb (2026-11-01)

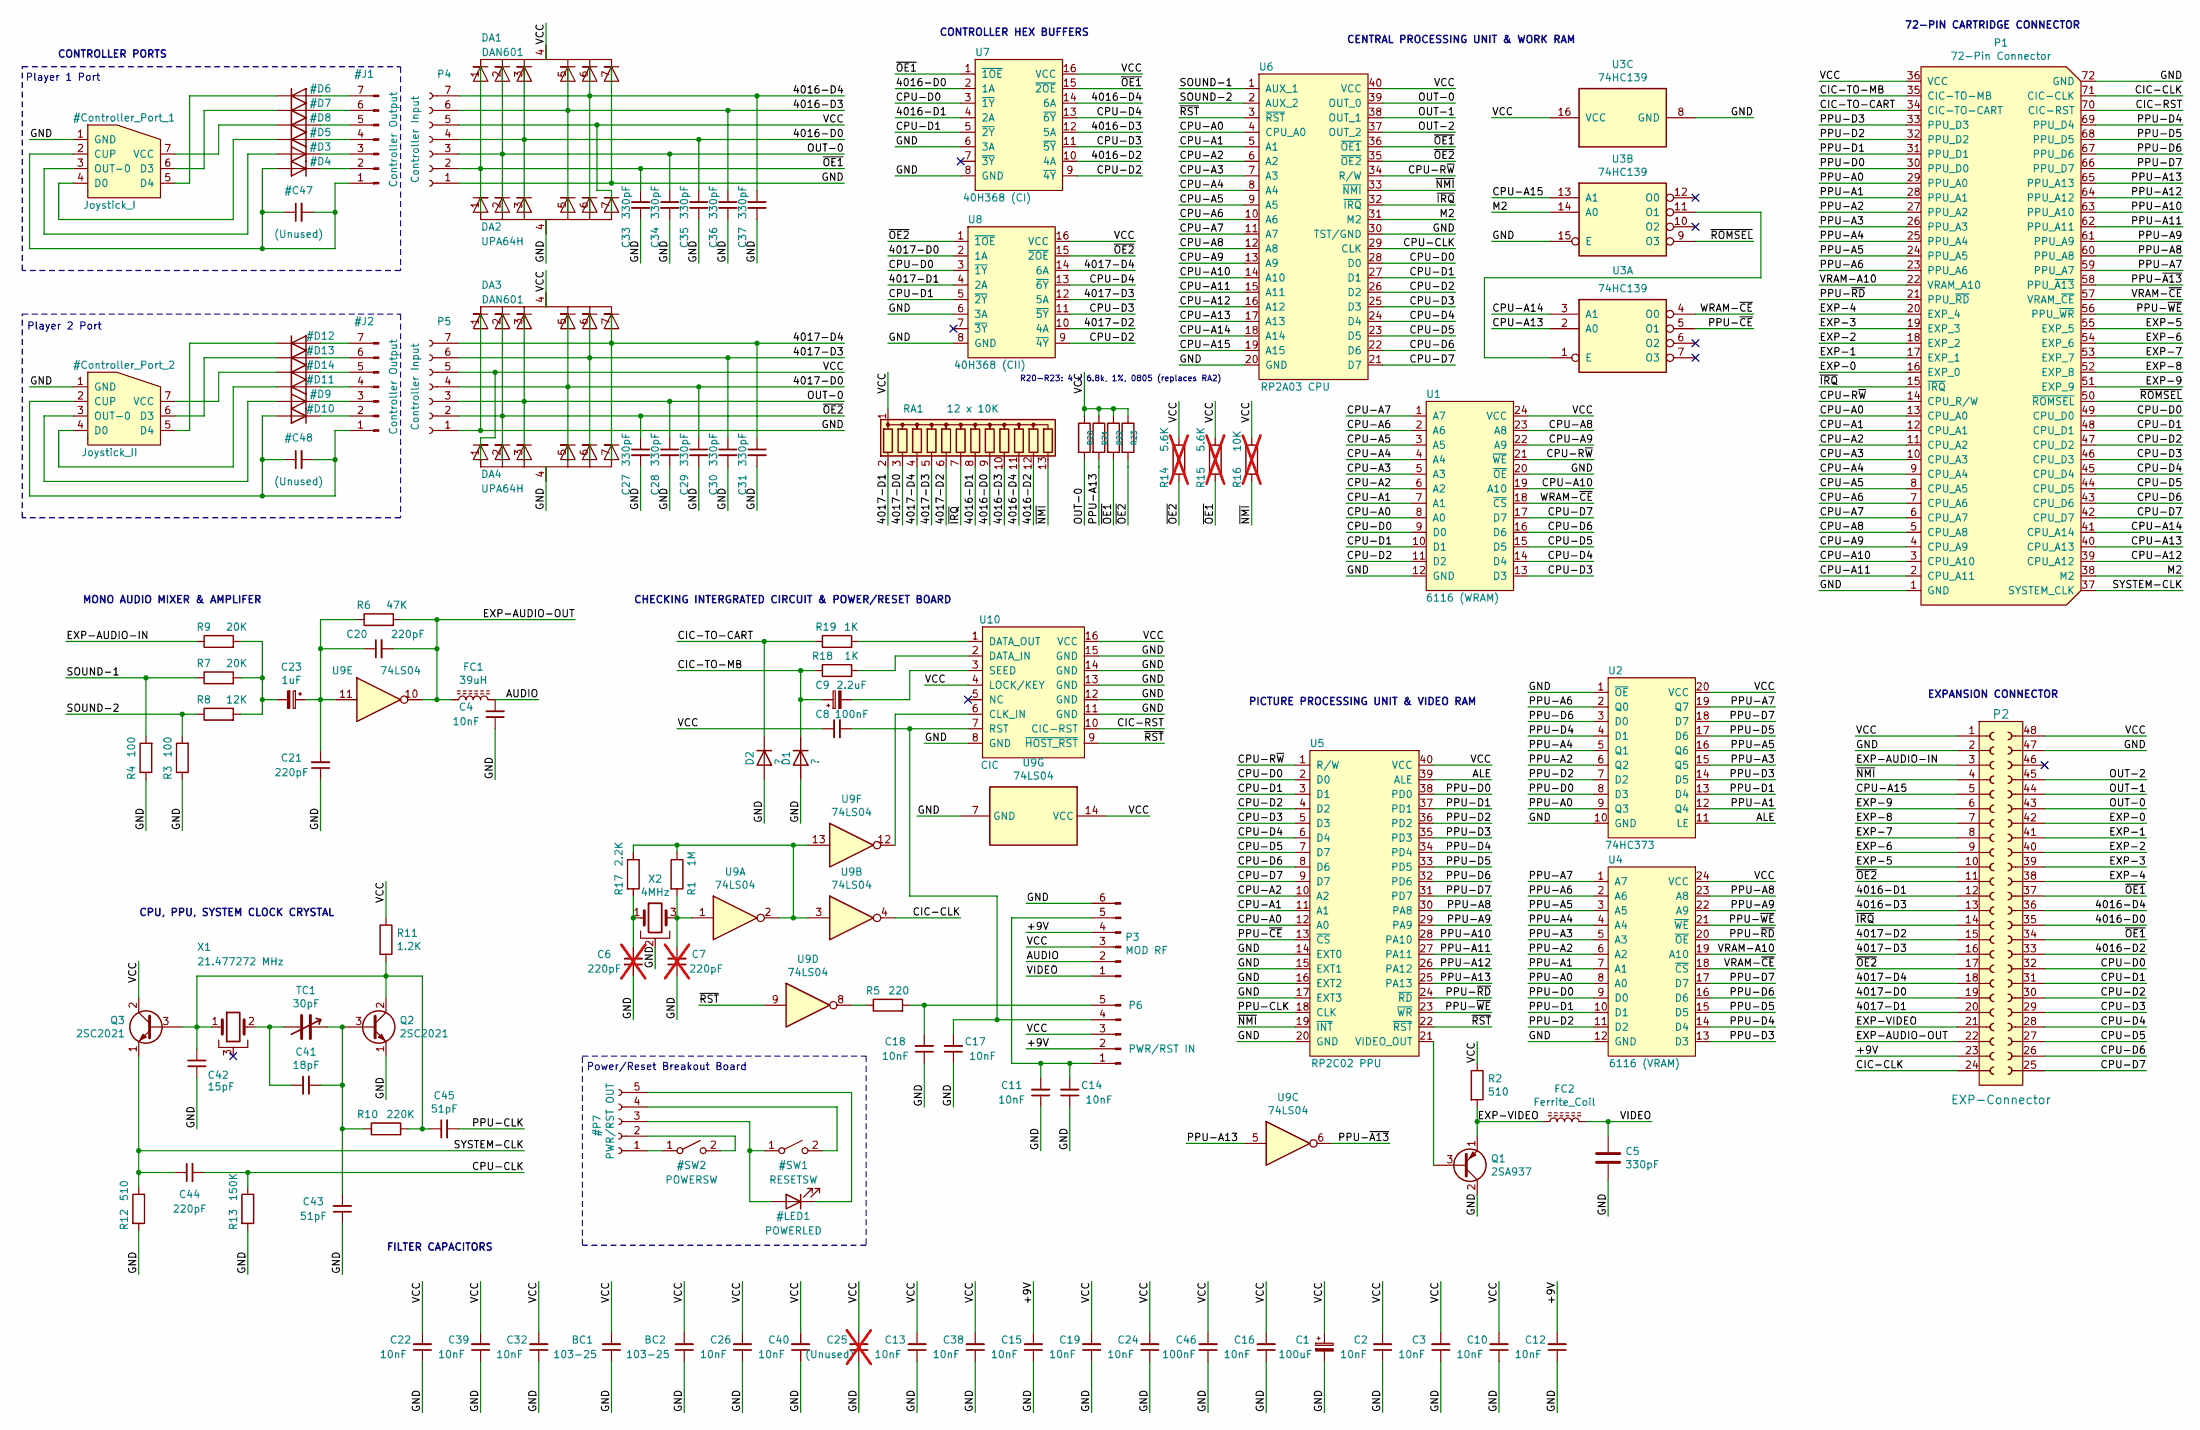
[picture p2: schematic Motherboard.kicad_sch, NES-CPU-11]

Parts:
BC1, BC2: 103-25; C_Disc_D6.0mm_W2.5mm_P5.00mm
C1: 100uF; CP_Radial_D5.0mm_P2.50mm
C2, C3, C4, C10, C11, C12, C13, C14, C15, C16, C17, C18, C19, C22, C24, C26, C32, C38, C39, C40: 10nF; C_Disc_D5.0mm_W2.5mm_P5.00mm
C5: 330pF; C_Disc_D3.0mm_W2.0mm_P2.50mm
C6, C7: 220pF; C_Disc_D3.0mm_W1.6mm_P2.50mm; not fitted
C8, C46: 100nF; C_Disc_D7.0mm_W2.5mm_P5.00mm
C9: 2.2uF; CP_Radial_D5.0mm_P2.50mm
C20, C21, C44: 220pF; C_Disc_D3.0mm_W1.6mm_P2.50mm
C23: 1uF; CP_Radial_D5.0mm_P2.50mm
C25: (Unused); C_Disc_D5.0mm_W2.5mm_P5.00mm; not fitted
C27, C28, C29, C30, C31, C33, C34, C35, C36, C37: 330pF; C_Disc_D3.0mm_W1.6mm_P2.50mm
C41: 18pF; C_Disc_D3.0mm_W2.0mm_P2.50mm
C42: 15pF; C_Disc_D3.4mm_W2.1mm_P2.50mm
C43, C45: 51pF; C_Disc_D3.4mm_W2.1mm_P2.50mm
D1, D2: ?; D_DO-35_SOD27_P10.16mm_Horizontal
DA1, DA3: DAN601; R_Array_SIP7
DA2, DA4: UPA64H; R_Array_SIP7
FC1: 39uH; R_Axial_DIN0207_L6.3mm_D2.5mm_P10.16mm_Horizontal
FC2: Ferrite_Coil; R_Axial_DIN0207_L6.3mm_D2.5mm_P10.16mm_Horizontal
P1: 72-Pin Connector; NES_Edge_Connector
P2: EXP-Connector; EXP_Header
P3: MOD RF; Mod_RF
P4, P5: Controller Input; JST_PH_S7B-PH-K_1x07_P2.00mm_Horizontal
P6: PWR/RST IN; PowerReset-switch-In
Q1: 2SA937; TO-126-3_Vertical_Short
Q2, Q3: 2SC2021; TO-126-3_Vertical_Short
R1: 1M; R_Axial_DIN0207_L6.3mm_D2.5mm_P10.16mm_Horizontal
R2, R12: 510; R_Axial_DIN0207_L6.3mm_D2.5mm_P10.16mm_Horizontal
R3, R4: 100; R_Axial_DIN0207_L6.3mm_D2.5mm_P10.16mm_Horizontal
R5: 220; R_Axial_DIN0207_L6.3mm_D2.5mm_P10.16mm_Horizontal
R6: 47K; R_Axial_DIN0207_L6.3mm_D2.5mm_P10.16mm_Horizontal
R7, R9: 20K; R_Axial_DIN0207_L6.3mm_D2.5mm_P10.16mm_Horizontal
R8: 12K; R_Axial_DIN0207_L6.3mm_D2.5mm_P10.16mm_Horizontal
R10: 220K; R_Axial_DIN0207_L6.3mm_D2.5mm_P10.16mm_Horizontal
R11: 1.2K; R_Axial_DIN0207_L6.3mm_D2.5mm_P10.16mm_Horizontal
R13: 150K; R_Axial_DIN0207_L6.3mm_D2.5mm_P10.16mm_Horizontal
R14, R15: 5.6K; R_Axial_DIN0207_L6.3mm_D2.5mm_P10.16mm_Horizontal; not fitted
R16: 10K; R_Axial_DIN0207_L6.3mm_D2.5mm_P10.16mm_Horizontal; not fitted
R17: 2.2K; R_Axial_DIN0207_L6.3mm_D2.5mm_P10.16mm_Horizontal
R18, R19: 1K; R_Axial_DIN0207_L6.3mm_D2.5mm_P10.16mm_Horizontal
R20, R21, R22, R23: 6.8k; R_0805_2012Metric_Pad1.20x1.40mm_HandSolder; MPN RC0805FR-076K8L
RA1: 12 x 10K; R_Array_SIP13
TC1: 30pF; TrimmerCap-THT
U1: 6116 (WRAM); DIP-24_W15.24-7.62mm
U2: 74HC373; DIP-20_W7.62mm
U3: 74HC139; DIP-16_W7.62mm
U4: 6116 (VRAM); DIP-24_W15.24-7.62mm
U5: RP2C02 PPU; DIP-40_W15.24mm
U6: RP2A03 CPU; DIP-40_W15.24mm
U7: 40H368 (CI); DIP-16_W7.62mm
U8: 40H368 (CII); DIP-16_W7.62mm
U9: 74LS04; DIP-14_W7.62mm
U10: CIC; DIP-16_W7.62mm
X1: 21.477272 MHz; Crystal_HC49-U_Horizontal_1EP_style2
X2: 4MHz; Resonator_Murata_CSTLSxxxG-3Pin_W8.0mm_H3.0mm

Connections:
/4016-D0: C35.1, DA1.3, DA2.3, P2.35, P4.4, RA1.9 (R8), U7.2 (1A)
/4016-D1: P2.12, RA1.8 (R7), U7.4 (2A)
/4016-D2: P2.33, RA1.12 (R11), U7.10 (4A)
/4016-D3: C36.1, DA1.5, DA2.5, P2.13, P4.6, RA1.10 (R9), U7.12 (5A)
/4016-D4: C37.1, DA1.6, DA2.6, P2.36, P4.7, RA1.11 (R10), U7.14 (6A)
/4017-D0: C29.1, DA3.5, DA4.5, P2.19, P5.4, RA1.3 (R2), U8.2 (1A)
/4017-D1: P2.20, RA1.2 (R1), U8.4 (2A)
/4017-D2: P2.15, RA1.6 (R5), U8.10 (4A)
/4017-D3: C30.1, DA3.6, DA4.6, P2.16, P5.6, RA1.5 (R4), U8.12 (5A)
/4017-D4: C31.1, DA3.7, DA4.7, P2.18, P5.7, RA1.4 (R3), U8.14 (6A)
/+9V: C12.2, C15.2, P2.23, P3.4, P6.2
/ALE: U2.11 (LE), U5.39 (ALE)
/AUDIO: C4.2, FC1.2, P3.2
/CIC-CLK: P1.71 (CIC-CLK), P2.24, U9.4
/CIC-RST: P1.70 (CIC-RST), U10.10 (CIC-RST)
/CIC-TO-CART: D2.1 (K), P1.34 (CIC-TO-CART), R19.1
/CIC-TO-MB: C9.1, D1.1 (K), P1.35 (CIC-TO-MB), R18.1
/CPU-A0: P1.13 (CPU_A0), U1.8 (A0), U5.12 (A0), U6.4 (CPU_A0)
/CPU-A1: P1.12 (CPU_A1), U1.7 (A1), U5.11 (A1), U6.5 (A1)
/CPU-A2: P1.11 (CPU_A2), U1.6 (A2), U5.10 (A2), U6.6 (A2)
/CPU-A3: P1.10 (CPU_A3), U1.5 (A3~), U6.7 (A3)
/CPU-A4: P1.9 (CPU_A4), U1.4 (A4~), U6.8 (A4)
/CPU-A5: P1.8 (CPU_A5), U1.3 (A5~), U6.9 (A5)
/CPU-A6: P1.7 (CPU_A6), U1.2 (A6~), U6.10 (A6)
/CPU-A7: P1.6 (CPU_A7), U1.1 (A7), U6.11 (A7)
/CPU-A8: P1.5 (CPU_A8), U1.23 (A8), U6.12 (A8)
/CPU-A9: P1.4 (CPU_A9), U1.22 (A9), U6.13 (A9)
/CPU-A10: P1.3 (CPU_A10), U1.19 (A10), U6.14 (A10)
/CPU-A11: P1.2 (CPU_A11), U6.15 (A11)
/CPU-A12: P1.39 (CPU_A12), U6.16 (A12)
/CPU-A13: P1.40 (CPU_A13), U3.2 (A0), U6.17 (A13)
/CPU-A14: P1.41 (CPU_A14), U3.3 (A1), U6.18 (A14)
/CPU-A15: P2.5, U3.13 (A1), U6.19 (A15)
/CPU-CLK: C44.2, R13.1, U6.29 (CLK)
/CPU-D0: P1.49 (CPU_D0), P2.32, U1.9 (D0), U5.2 (D0), U6.28 (D0), U7.3 (~1Y), U8.3 (~1Y)
/CPU-D1: P1.48 (CPU_D1), P2.31, U1.10 (D1), U5.3 (D1), U6.27 (D1), U7.5 (~2Y), U8.5 (~2Y)
/CPU-D2: P1.47 (CPU_D2), P2.30, U1.11 (D2), U5.4 (D2), U6.26 (D2), U7.9 (~4Y), U8.9 (~4Y)
/CPU-D3: P1.46 (CPU_D3), P2.29, U1.13 (D3), U5.5 (D3), U6.25 (D3), U7.11 (~5Y), U8.11 (~5Y)
/CPU-D4: P1.45 (CPU_D4), P2.28, U1.14 (D4), U5.6 (D4), U6.24 (D4), U7.13 (~6Y), U8.13 (~6Y)
/CPU-D5: P1.44 (CPU_D5), P2.27, U1.15 (D5), U5.7 (D7), U6.23 (D5)
/CPU-D6: P1.43 (CPU_D6), P2.26, U1.16 (D6), U5.8 (D6), U6.22 (D6)
/CPU-D7: P1.42 (CPU_D7), P2.25, U1.17 (D7), U5.9 (D7), U6.21 (D7)
/CPU-R~W: P1.14 (CPU_R/W), U1.21 (~WE), U5.1 (R/W), U6.34 (R/W)
/EXP-0: P1.16 (EXP_0), P2.42
/EXP-1: P1.17 (EXP_1), P2.41
/EXP-2: P1.18 (EXP_2), P2.40
/EXP-3: P1.19 (EXP_3), P2.39
/EXP-4: P1.20 (EXP_4), P2.38
/EXP-5: P1.55 (EXP_5), P2.10
/EXP-6: P1.54 (EXP_6), P2.9
/EXP-7: P1.53 (EXP_7), P2.8
/EXP-8: P1.52 (EXP_8), P2.7
/EXP-9: P1.51 (EXP_9), P2.6
/EXP-AUDIO-IN: P2.3, R9.1
/EXP-AUDIO-OUT: C20.2, FC1.1, P2.22, R6.2, U9.10
/EXP-VIDEO: FC2.1, P2.21, Q1.1 (E), R2.2
/GND: BC1.1, BC2.1, C1.2, C2.1, C3.1, C4.1, C5.2, C6.1, C7.1, C10.1, C11.1, C12.1, C13.1, C14.1, C15.1, C16.1, C17.1, C18.1, C19.1, C21.1, C22.1, C24.1, C25.1, C26.1, C27.2, C28.2, C29.2, C30.2, C31.2, C32.1, C33.2, C34.2, C35.2, C36.2, C37.2, C38.1, C39.1, C40.1, C42.1, C43.1, C46.1, D1.2 (A), D2.2 (A), DA1.7, DA2.4, DA3.1, DA4.4, P1.1 (GND), P1.72 (GND), P2.2, P2.47, P3.6, P4.1, P5.1, Q1.2 (C), Q2.1 (E), R3.1, R4.1, R12.2, R13.2, U1.12 (GND~), U1.20 (~OE), U2.1 (~OE), U2.10 (GND), U3.8 (GND), U3.15 (E), U4.12 (GND~), U5.14 (EXT0), U5.15 (EXT1), U5.16 (EXT2), U5.17 (EXT3), U5.20 (GND), U6.20 (GND), U6.30 (TST/GND), U7.6 (3A), U7.8 (GND), U8.6 (3A), U8.8 (GND), U9.7 (GND), U10.8 (GND), U10.11 (GND), U10.12 (GND), U10.13 (GND), U10.14 (GND), U10.15 (GND), X2.2
/M2: P1.38 (M2), U3.14 (A0), U6.31 (M2)
/OUT-0: C28.1, C34.1, DA1.2, DA2.2, DA3.3, DA4.3, P2.43, P4.3, P5.3, R20.2, U6.39 (OUT_0)
/OUT-1: P2.44, U6.38 (OUT_1)
/OUT-2: P2.45, U6.37 (OUT_2)
/PPU-A0: P1.29 (PPU_A0), U2.9 (Q3), U4.8 (A0)
/PPU-A1: P1.28 (PPU_A1), U2.12 (Q4), U4.7 (A1)
/PPU-A2: P1.27 (PPU_A2), U2.6 (Q2), U4.6 (A2)
/PPU-A3: P1.26 (PPU_A3), U2.15 (Q5), U4.5 (A3~)
/PPU-A4: P1.25 (PPU_A4), U2.5 (Q1), U4.4 (A4~)
/PPU-A5: P1.24 (PPU_A5), U2.16 (Q6), U4.3 (A5~)
/PPU-A6: P1.23 (PPU_A6), U2.2 (Q0), U4.2 (A6~)
/PPU-A7: P1.59 (PPU_A7), U2.19 (Q7), U4.1 (A7)
/PPU-A8: P1.60 (PPU_A8), U4.23 (A8), U5.30 (PA8)
/PPU-A9: P1.61 (PPU_A9), U4.22 (A9), U5.29 (PA9)
/PPU-A10: P1.63 (PPU_A10), U5.28 (PA10)
/PPU-A11: P1.62 (PPU_A11), U5.27 (PA11)
/PPU-A12: P1.64 (PPU_A12), U5.26 (PA12)
/PPU-A13: P1.65 (PPU_A13), R21.2, U5.25 (PA13), U9.5
/PPU-CLK: C45.2, U5.18 (CLK)
/PPU-D0: P1.30 (PPU_D0), U2.8 (D3), U4.9 (D0), U5.38 (PD0)
/PPU-D1: P1.31 (PPU_D1), U2.13 (D4), U4.10 (D1), U5.37 (PD1)
/PPU-D2: P1.32 (PPU_D2), U2.7 (D2), U4.11 (D2), U5.36 (PD2)
/PPU-D3: P1.33 (PPU_D3), U2.14 (D5), U4.13 (D3), U5.35 (PD3)
/PPU-D4: P1.69 (PPU_D4), U2.4 (D1), U4.14 (D4), U5.34 (PD4)
/PPU-D5: P1.68 (PPU_D5), U2.17 (D6), U4.15 (D5), U5.33 (PD5)
/PPU-D6: P1.67 (PPU_D6), U2.3 (D0), U4.16 (D6), U5.32 (PD6)
/PPU-D7: P1.66 (PPU_D7), U2.18 (D7), U4.17 (D7), U5.31 (PD7)
/PPU-~A13: P1.58 (PPU_~A13), U9.6
/PPU-~CE: U3.5 (O1), U5.13 (~CS)
/PPU-~RD: P1.21 (PPU_~RD), U4.20 (~OE), U5.24 (~RD)
/PPU-~WE: P1.56 (PPU_~WR), U4.21 (~WE), U5.23 (~WR)
/SOUND-1: R4.2, R7.1, U6.1 (AUX_1)
/SOUND-2: R3.2, R8.1, U6.2 (AUX_2)
/SYSTEM-CLK: C44.1, P1.37 (SYSTEM_CLK), Q3.1 (E), R12.1
/VCC: BC1.2, BC2.2, C1.1, C2.2, C3.2, C8.1, C10.2, C13.2, C16.2, C19.2, C22.2, C24.2, C25.2, C26.2, C32.2, C38.2, C39.2, C40.2, C46.2, DA1.4, DA2.7, DA3.4, DA4.1, P1.36 (VCC), P2.1, P2.48, P3.3, P4.5, P5.5, P6.3, Q3.2 (C), R2.1, R11.1, R14.1, R15.1, R16.1, R20.1, R21.1, R22.1, R23.1, RA1.1 (common), U1.24 (VCC), U2.20 (VCC), U3.16 (VCC), U4.24 (VCC), U5.40 (VCC), U6.40 (VCC), U7.16 (VCC), U8.16 (VCC), U9.14 (VCC), U10.4 (LOCK/KEY), U10.16 (VCC)
/VIDEO: C5.1, FC2.2, P3.1
/VRAM-A10: P1.22 (VRAM_A10), U4.19 (A10)
/VRAM-~CE: P1.57 (VRAM_~CE), U4.18 (~CS)
/WRAM-~CE: U1.18 (~CS), U3.4 (O0)
/~IRQ: P1.15 (~IRQ), P2.14, RA1.7 (R6), U6.32 (~IRQ)
/~NMI: P2.4, R16.2, RA1.13 (R12), U5.19 (~INT), U6.33 (~NMI)
/~OE1: C33.1, DA1.1, DA2.1, P2.34, P2.37, P4.2, R15.2, R22.2, U6.36 (~OE1), U7.1 (~1OE), U7.15 (~2OE)
/~OE2: C27.1, DA3.2, DA4.2, P2.11, P2.17, P5.2, R14.2, R23.2, U6.35 (~OE2), U8.1 (~1OE), U8.15 (~2OE)
/~ROMSEL: P1.50 (~ROMSEL), U3.9 (O3)
/~RST: U5.22 (~RST), U6.3 (~RST), U9.9, U10.9 (~HOST_RST)
unnamed: C6.2, R17.2, X2.1
unnamed: C7.2, R1.2, U9.1, X2.3
unnamed: C20.1, C21.2, C23.1, R6.1, U9.11
unnamed: C23.2, R7.2, R8.2, R9.2
unnamed: C41.1, TC1.2, X1.2
unnamed: C11.2, C14.2, P3.5, P6.1
unnamed: C8.2, C17.2, P6.4, U10.7 (RST)
unnamed: C18.2, P6.5, R5.2
unnamed: Q1.3 (B), U5.21 (VIDEO_OUT)
unnamed: C41.2, C43.2, Q2.3 (B), R10.1, TC1.1
unnamed: C42.2, C45.1, Q2.2 (C), Q3.3 (B), R10.2, R11.2, X1.1
unnamed: R1.1, R17.1, U9.2, U9.3, U9.13
unnamed: R5.1, U9.8
unnamed: U3.1 (E), U3.11 (O1)
unnamed: U9.12, U10.6 (CLK_IN)
unnamed: R18.2, U10.2 (DATA_IN)
unnamed: R19.2, U10.1 (DATA_OUT)
unnamed: C9.2, U10.3 (SEED)

Notes on the sheet:
72-PIN CARTRIDGE CONNECTOR
MONO AUDIO MIXER & AMPLIFER
CENTRAL PROCESSING UNIT & WORK RAM
CONTROLLER PORTS
EXPANSION CONNECTOR
FILTER CAPACITORS
Player 2 Port
Player 1 Port
Power/Reset Breakout Board
CHECKING INTERGRATED CIRCUIT & POWER/RESET BOARD
PICTURE PROCESSING UNIT & VIDEO RAM
CPU, PPU, SYSTEM CLOCK CRYSTAL
CONTROLLER HEX BUFFERS
R20-R23: 4 x 6.8k, 1%, 0805 (replaces RA2)

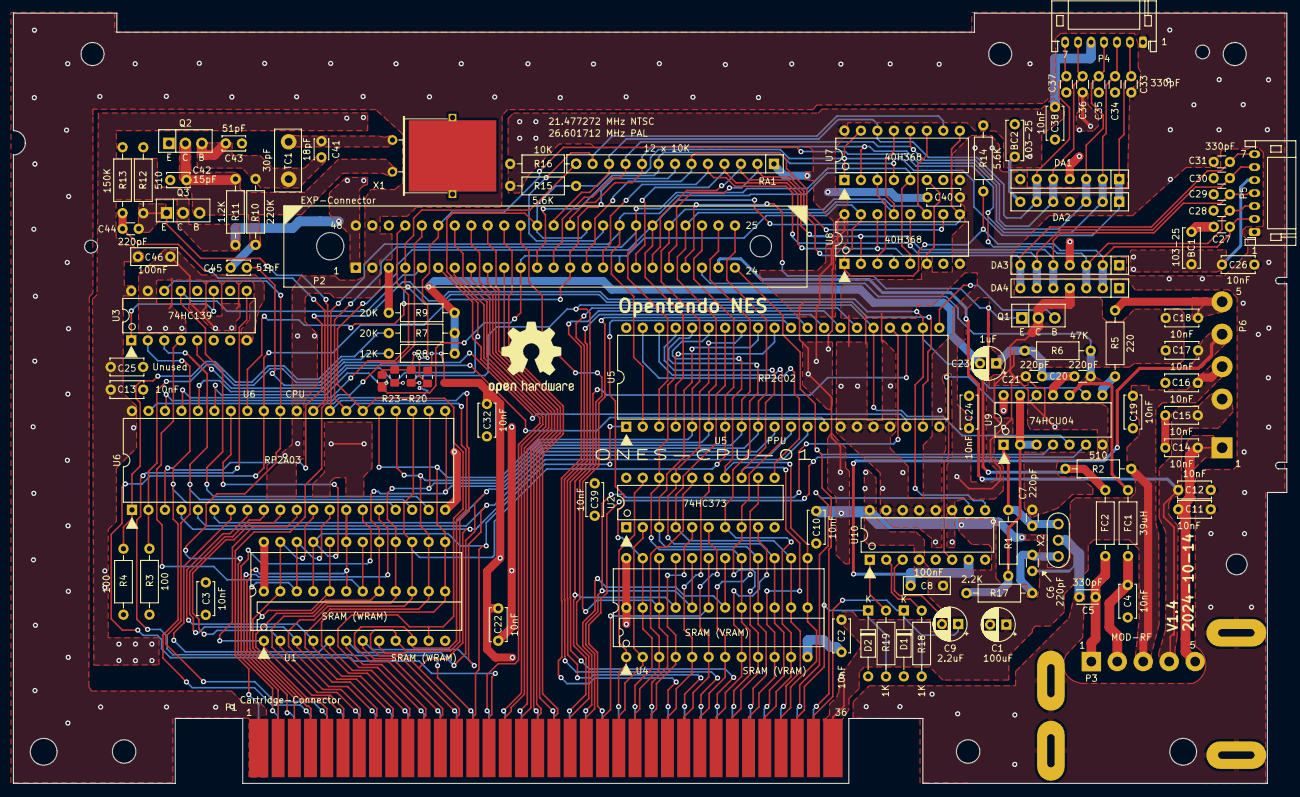
[picture p3: board Motherboard.kicad_pcb from above]

Board: 2 copper layers, 196.3 x 118.7 mm, 102 parts (0 on the bottom side), 120 nets.
