ckrautwald/OpenTendo/adapters/ra2/RA2-modern-adapter.kicad_pcb

## KiCad design adapters/ra2/RA2-modern-adapter.kicad_pcb (2026-11-01)

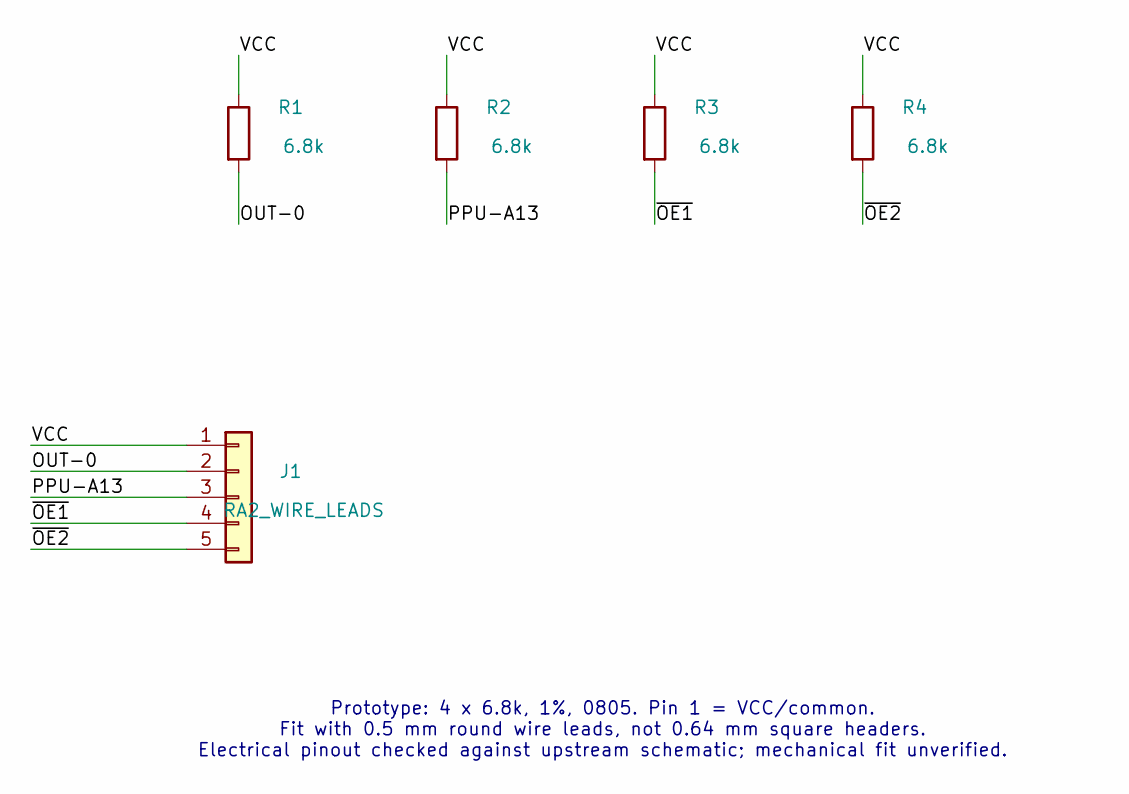
[picture p4: schematic RA2-modern-adapter.kicad_sch, OpenTendo RA2 - four-resistor adapter]

Parts:
J1: RA2_WIRE_LEADS; SIP5_WireLeads_P2.54mm
R1, R2, R3, R4: 6.8k; R_0805_2012Metric_Pad1.20x1.40mm_HandSolder; MPN RC0805FR-076K8L

Connections:
/OUT-0: J1.2, R1.2
/PPU-A13: J1.3, R2.2
/VCC: J1.1, R1.1, R2.1, R3.1, R4.1
/~OE1: J1.4, R3.2
/~OE2: J1.5, R4.2

Notes on the sheet:
Prototype: 4 x 6.8k, 1%, 0805. Pin 1 = VCC/common. Fit with 0.5 mm round wire leads, not 0.64 mm square headers. Electrical pinout checked against upstream schematic; mechanical fit unverified.

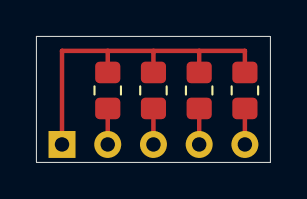
[picture p5: board RA2-modern-adapter.kicad_pcb from above]

Board: 2 copper layers, 13.0 x 7.0 mm, 5 parts (0 on the bottom side), 5 nets.
