ckrautwald/OpenTendo/(commit log)

2026-11-01 Add RA2 modern-component adapter prototype
    [BOM.csv, RA2-modern-adapter.kicad_pcb, RA2-modern-adapter.kicad_sch]
2026-11-01 Replace motherboard RA2 with four modern 0805 resistors
    [BOM.csv, Motherboard.kicad_pcb, Motherboard.kicad_sch]
